MatthiasRubin/rc-truck/3d/chassis/frontSection/axleMountFrame/axleMountFrame.3mf

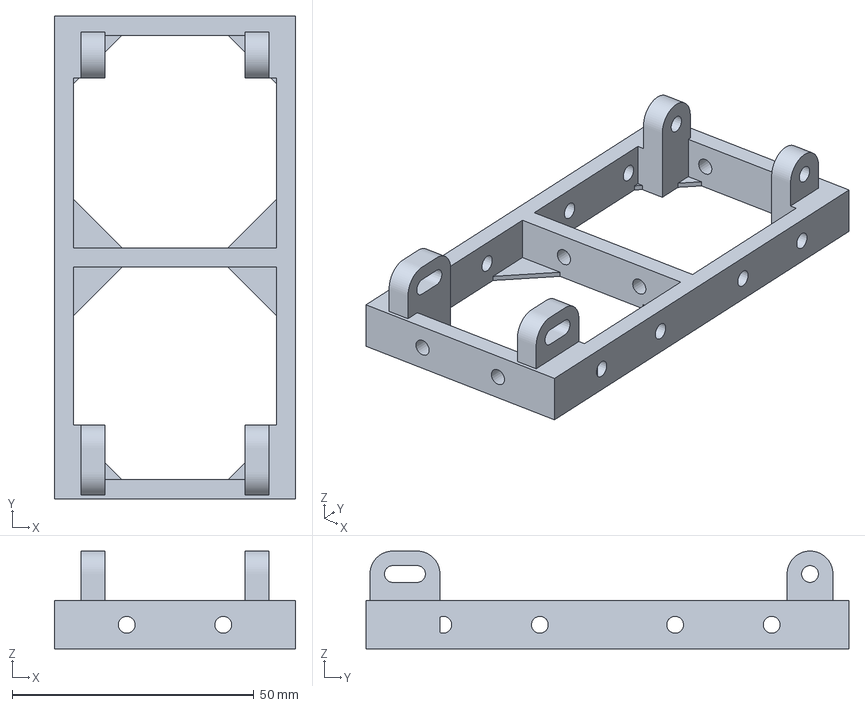
[picture p1: CAD file, 2021-02-16]
3d/chassis/frontSection/axleMountFrame/axleMountFrame.3mf
50.0 x 100.0 x 20.3 mm
