MatthiasRubin/rc-truck/3d/chassis/frontSection/frontAxle/axleBeam/axleBeamBottom.stl

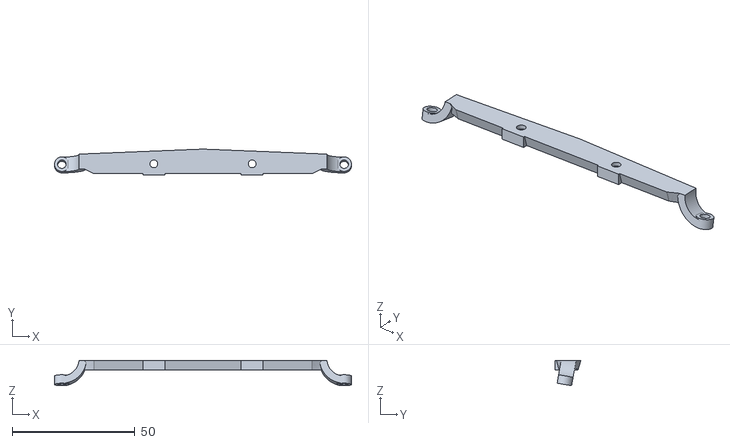
[picture p2: CAD file, 2021-02-10]
3d/chassis/frontSection/frontAxle/axleBeam/axleBeamBottom.stl
120.8 x 10.5 x 10.4
