MatthiasRubin/rc-truck/3d/chassis/frontSection/frontAxle/bearing/bearing.stl

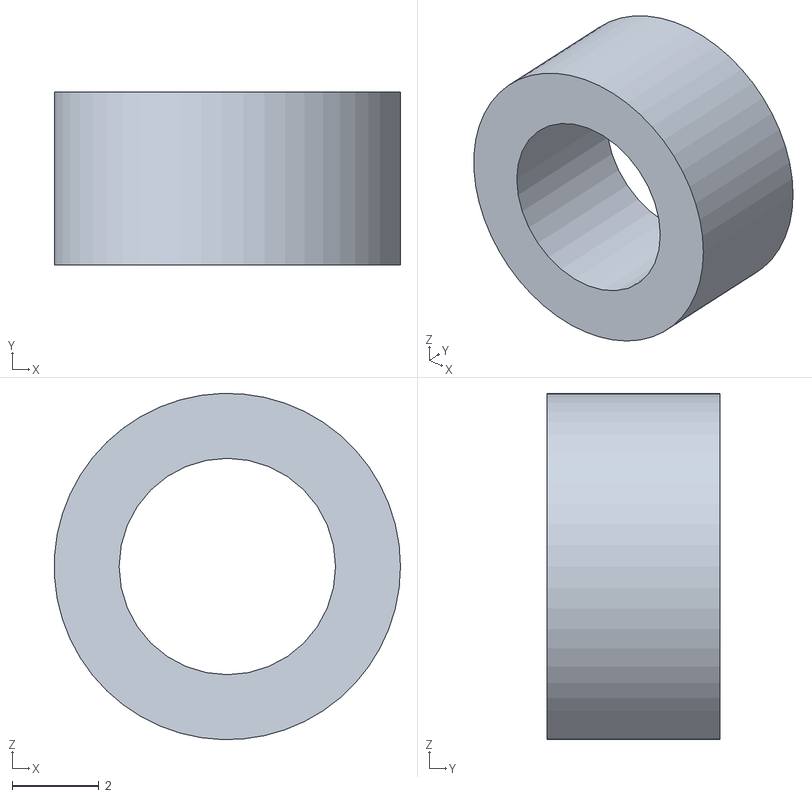
[picture p3: CAD file, 2021-02-10]
3d/chassis/frontSection/frontAxle/bearing/bearing.stl
7.99 x 4.00 x 8.00
