MatthiasRubin/rc-truck/3d/chassis/frontSection/frontAxle/shaft/shafts.3mf

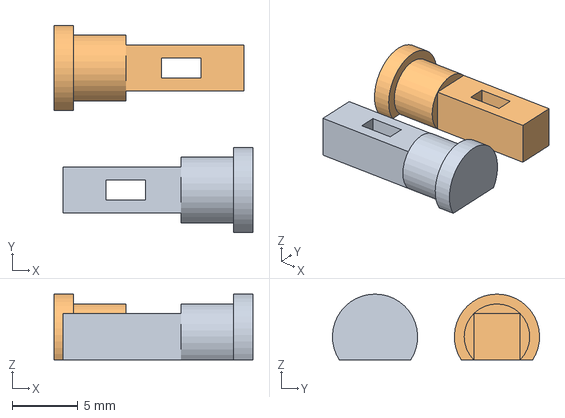
[picture p4: CAD file, 2021-02-10]
3d/chassis/frontSection/frontAxle/shaft/shafts.3mf
15.2 x 15.8 x 5.02 mm
shaft.stl
shaft.stl(1)
