MatthiasRubin/rc-truck/3d/chassis/frontSection/frontAxle/steeringKnuckles/bearingHousing.stl

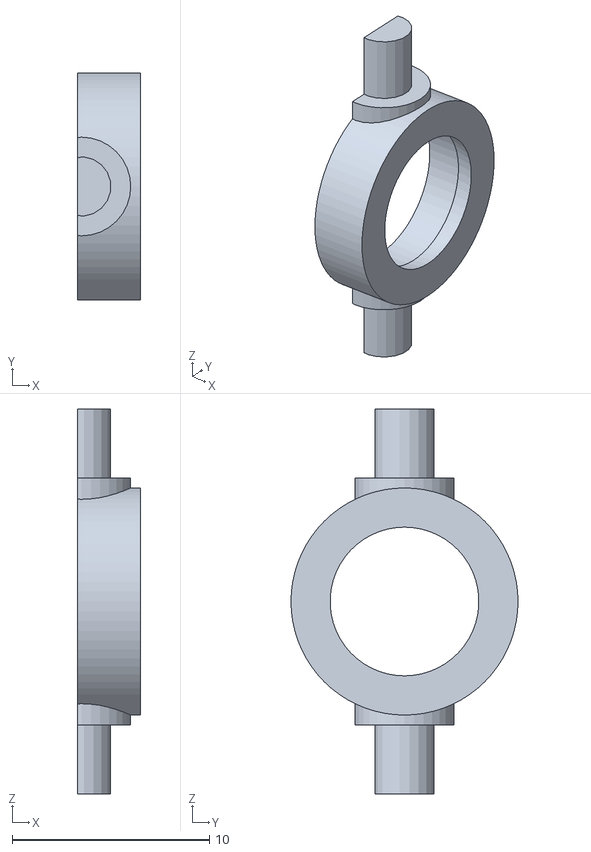
[picture p5: CAD file, 2021-02-10]
3d/chassis/frontSection/frontAxle/steeringKnuckles/bearingHousing.stl
3.20 x 11.5 x 19.5
