MatthiasRubin/rc-truck/3d/chassis/frontSection/frontAxle/steeringRod/steeringRod.3mf

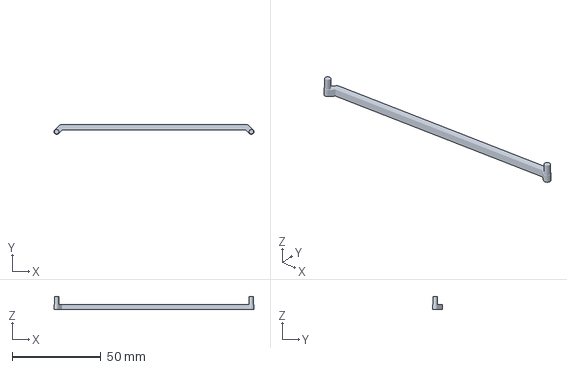
[picture p6: CAD file, 2021-02-10]
3d/chassis/frontSection/frontAxle/steeringRod/steeringRod.3mf
113.0 x 5.49 x 7.50 mm
