MatthiasRubin/rc-truck/3d/chassis/frontSection/frontAxle/wheelhub/wheelClip.stl

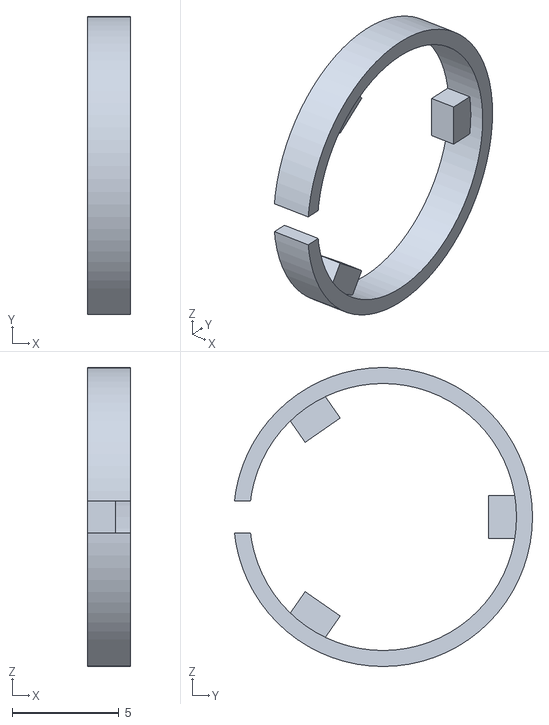
[picture p7: CAD file, 2021-02-10]
3d/chassis/frontSection/frontAxle/wheelhub/wheelClip.stl
2.00 x 14.0 x 14.0
