MatthiasRubin/rc-truck/3d/chassis/frontSection/suspension/suspension.3mf

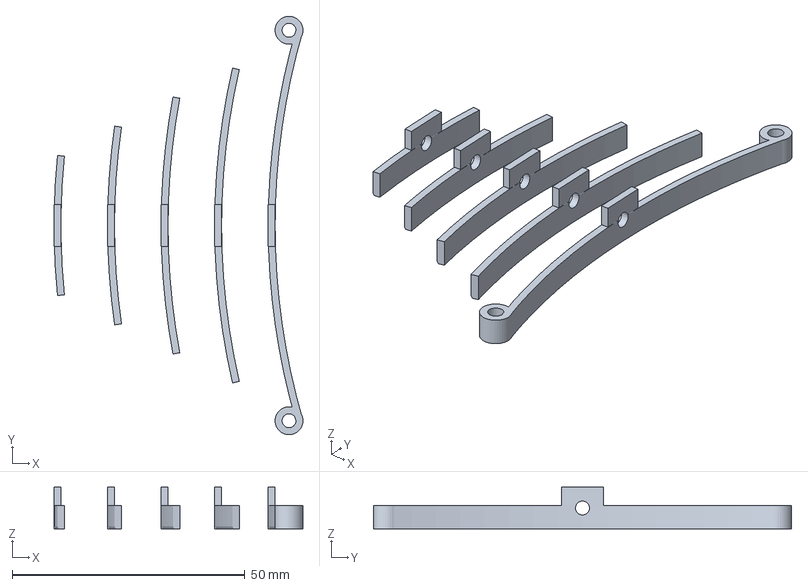
[picture p8: CAD file, 2021-02-11]
3d/chassis/frontSection/suspension/suspension.3mf
53.5 x 89.8 x 9.01 mm
