MatthiasRubin/rc-truck/3d/chassis/middleSection/middleSection.3mf

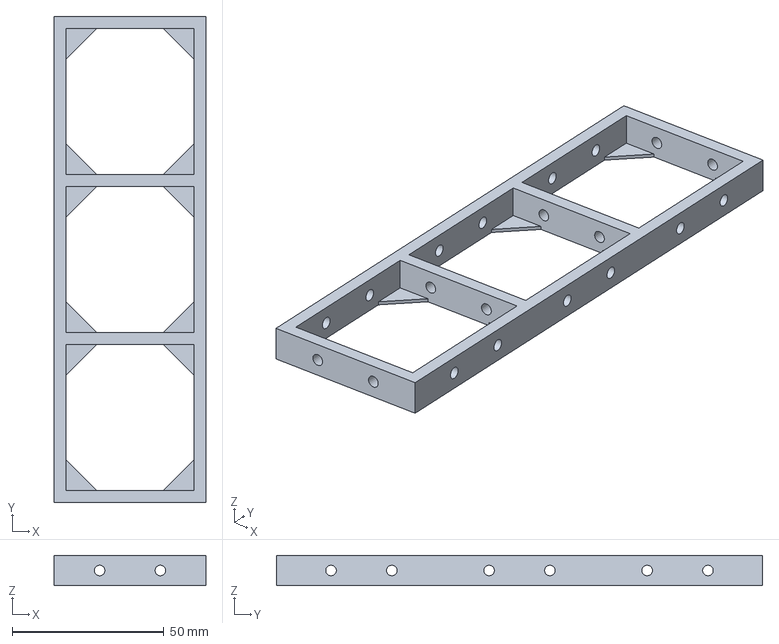
[picture p9: CAD file, 2021-02-16]
3d/chassis/middleSection/middleSection.3mf
50.0 x 160.0 x 10.0 mm
