MatthiasRubin/rc-truck/3d/chassis/rearSection/axleMountFrame/axleMountFrame.3mf

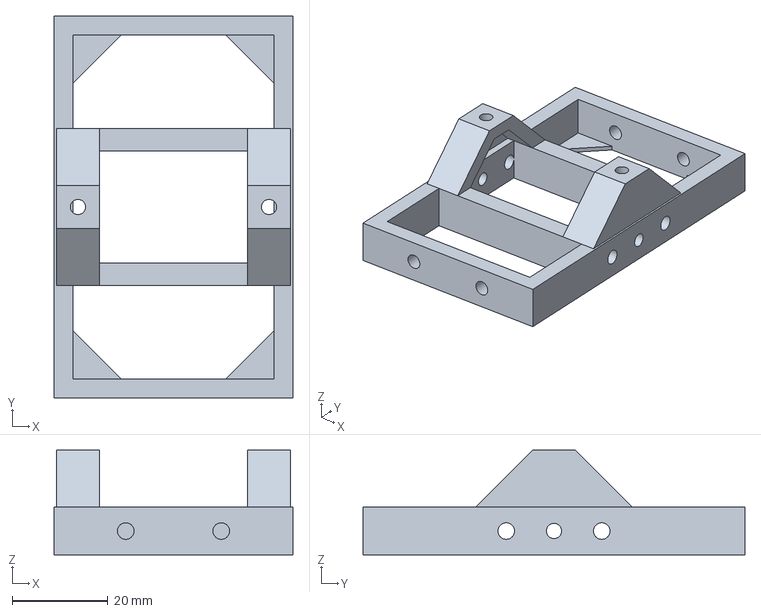
[picture p10: CAD file, 2021-02-16]
3d/chassis/rearSection/axleMountFrame/axleMountFrame.3mf
50.0 x 80.0 x 22.0 mm
