MatthiasRubin/rc-truck/3d/chassis/rearSection/rearAxle/bearings/outputBearing.stl

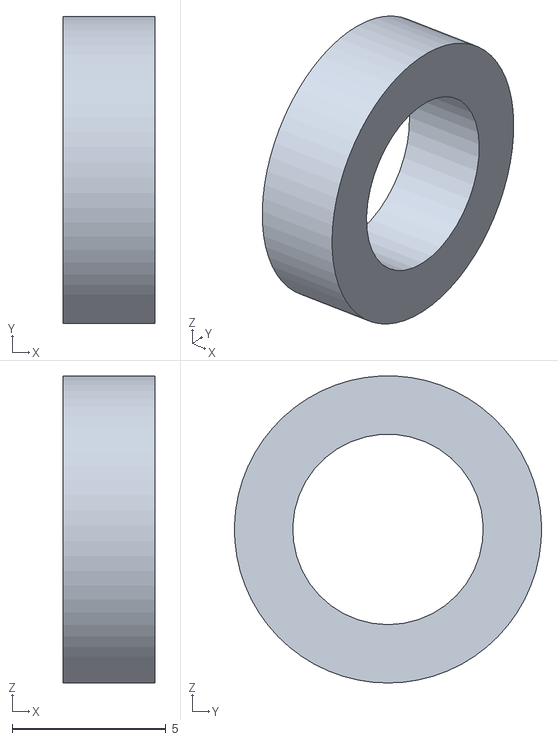
[picture p11: CAD file, 2021-02-10]
3d/chassis/rearSection/rearAxle/bearings/outputBearing.stl
3.00 x 10.00 x 9.99
