MatthiasRubin/rc-truck/3d/chassis/rearSection/rearAxle/gears/outputGear.stl

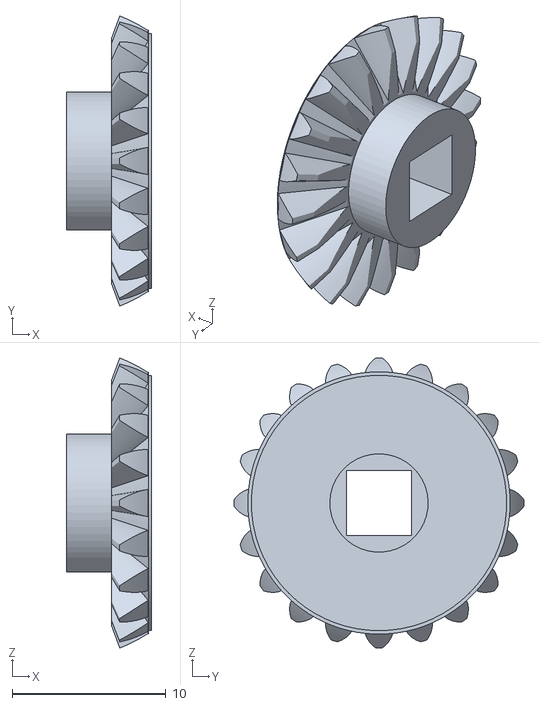
[picture p12: CAD file, 2021-02-10]
3d/chassis/rearSection/rearAxle/gears/outputGear.stl
5.51 x 18.9 x 18.9
