MatthiasRubin/rc-truck/3d/chassis/rearSection/rearAxle/housing/housingTop.3mf

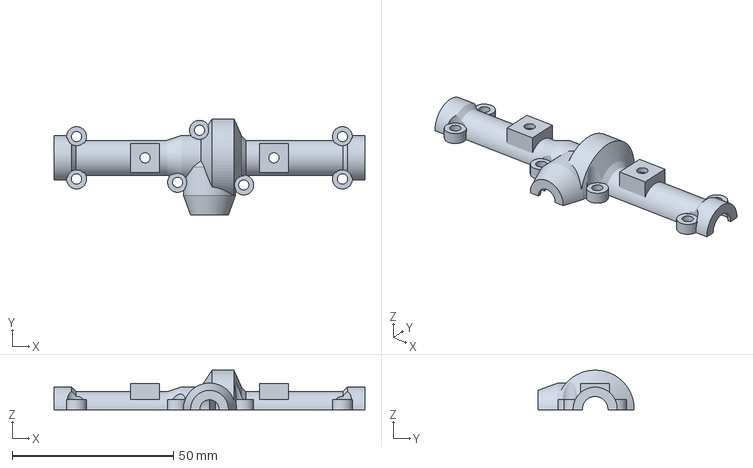
[picture p13: CAD file, 2021-02-10]
3d/chassis/rearSection/rearAxle/housing/housingTop.3mf
96.5 x 29.9 x 12.3 mm
