MatthiasRubin/rc-truck/3d/chassis/rearSection/rearAxle/shafts/inputShaft.stl

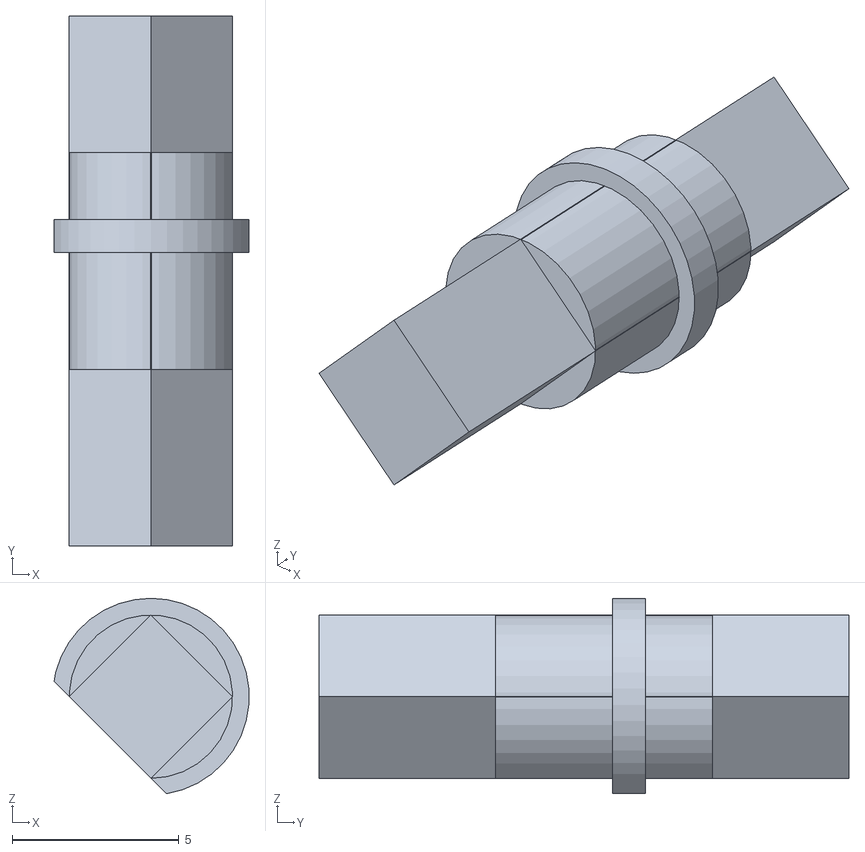
[picture p14: CAD file, 2021-02-10]
3d/chassis/rearSection/rearAxle/shafts/inputShaft.stl
5.84 x 15.9 x 5.86
