MatthiasRubin/rc-truck/3d/chassis/rearSection/rearAxle/wheelHub/wheelHub.3mf

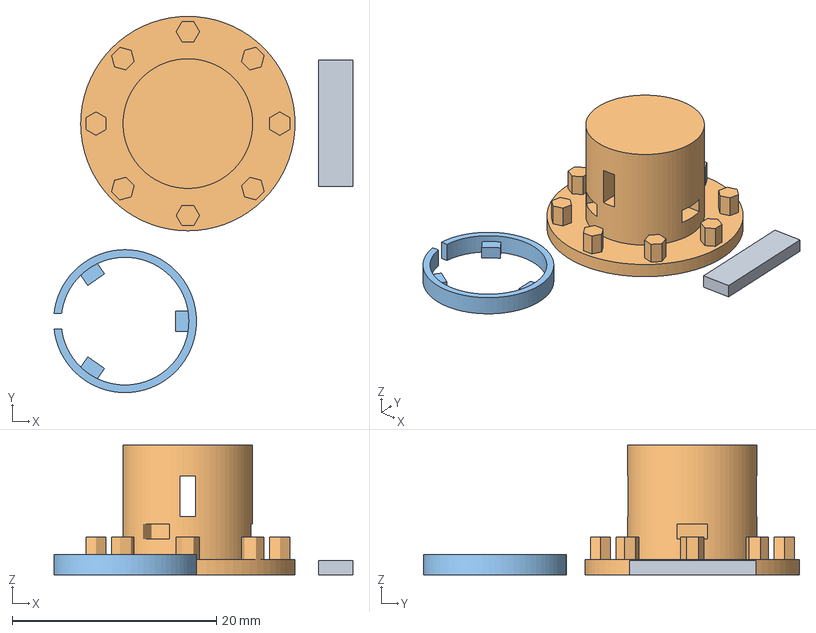
[picture p15: CAD file, 2021-02-10]
3d/chassis/rearSection/rearAxle/wheelHub/wheelHub.3mf
29.3 x 36.8 x 12.7 mm
wheelHubLatch.stl
wheelHub.stl
wheelClip.stl
