MatthiasRubin/rc-truck/3d/chassis/wheel/rim/tire.3mf

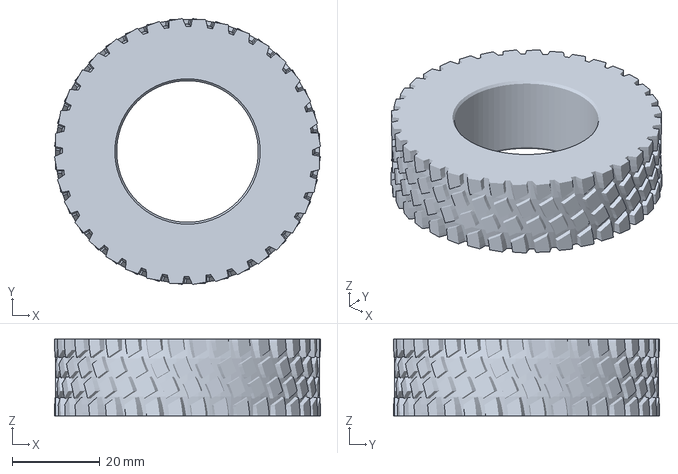
[picture p16: CAD file, 2021-02-10]
3d/chassis/wheel/rim/tire.3mf
60.5 x 60.5 x 17.5 mm
