MatthiasRubin/rc-truck/3d/chassis/wheel/tire/rim.3mf

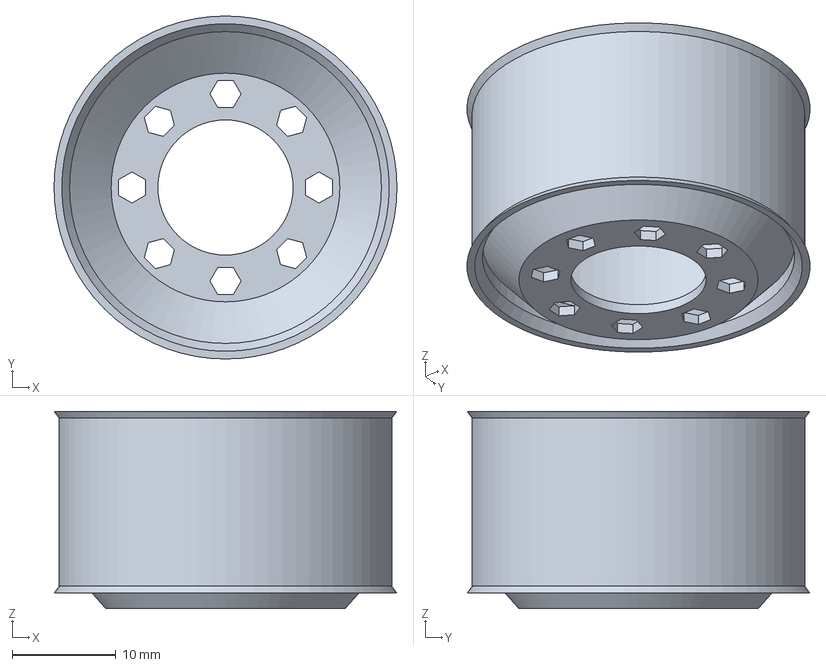
[picture p17: CAD file, 2021-02-10]
3d/chassis/wheel/tire/rim.3mf
33.0 x 33.0 x 19.0 mm
