MatthiasRubin/rc-truck/3d/chassis/frontSection/frontAxle/axleBeam/axleBeam.3mf

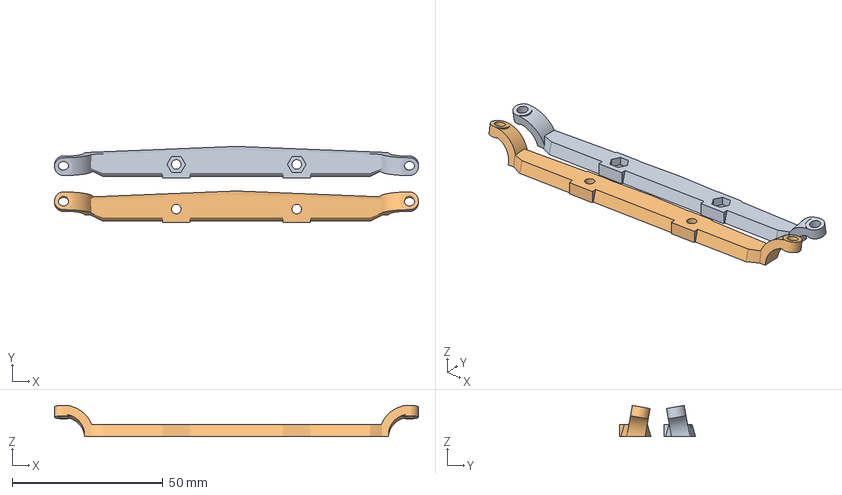
[picture p18: CAD file, 2021-02-10]
3d/chassis/frontSection/frontAxle/axleBeam/axleBeam.3mf
120.8 x 25.3 x 10.4 mm
axleBeamBottom.stl
axleBeamTop.stl
