MatthiasRubin/rc-truck/3d/chassis/frontSection/frontAxle/bearing/bearings.3mf

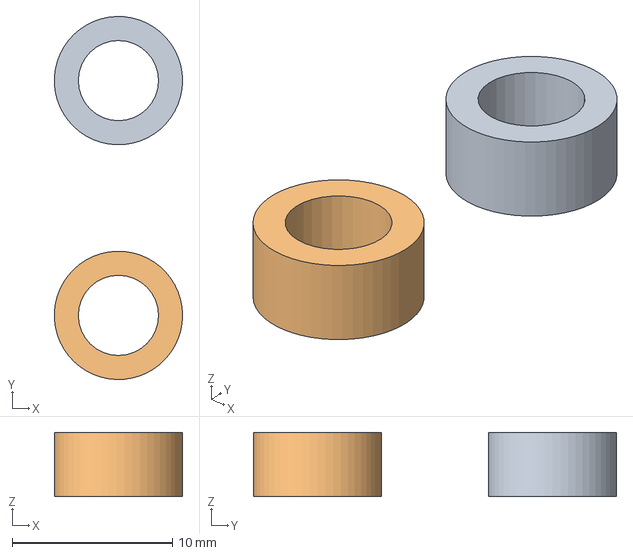
[picture p19: CAD file, 2021-02-10]
3d/chassis/frontSection/frontAxle/bearing/bearings.3mf
7.99 x 22.6 x 4.00 mm
bearing.stl
bearing.stl(1)
