MatthiasRubin/rc-truck/3d/chassis/frontSection/frontAxle/shaft/shaft.stl

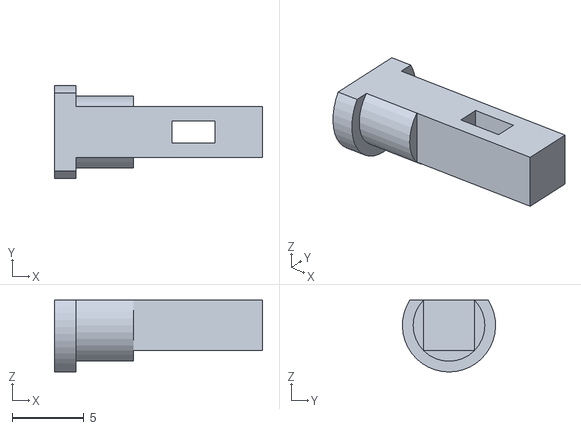
[picture p20: CAD file, 2021-02-10]
3d/chassis/frontSection/frontAxle/shaft/shaft.stl
14.5 x 6.50 x 5.02
