MatthiasRubin/rc-truck/3d/chassis/frontSection/frontAxle/steeringKnuckles/doubleSteeringKnuckle.stl

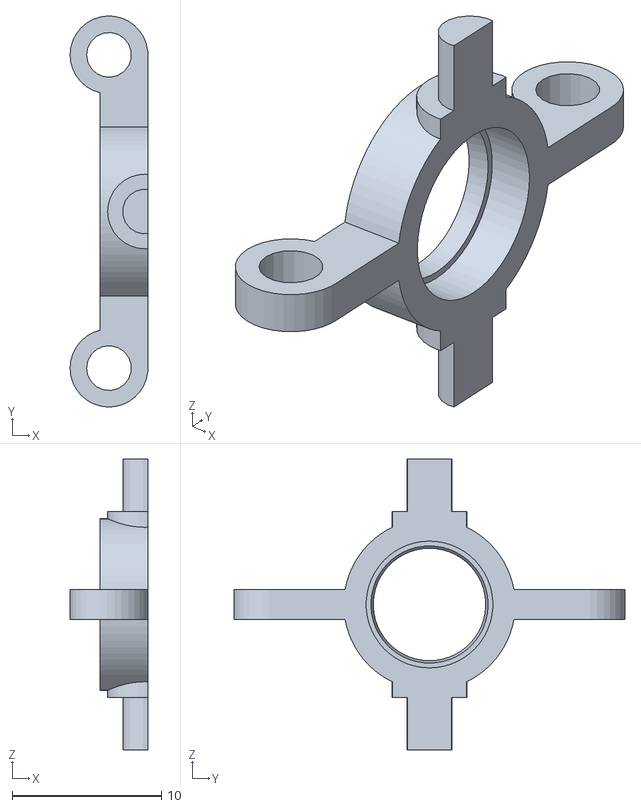
[picture p21: CAD file, 2021-02-10]
3d/chassis/frontSection/frontAxle/steeringKnuckles/doubleSteeringKnuckle.stl
5.22 x 26.2 x 19.5
