MatthiasRubin/rc-truck/3d/chassis/frontSection/frontAxle/wheelhub/wheelHubLatch.stl

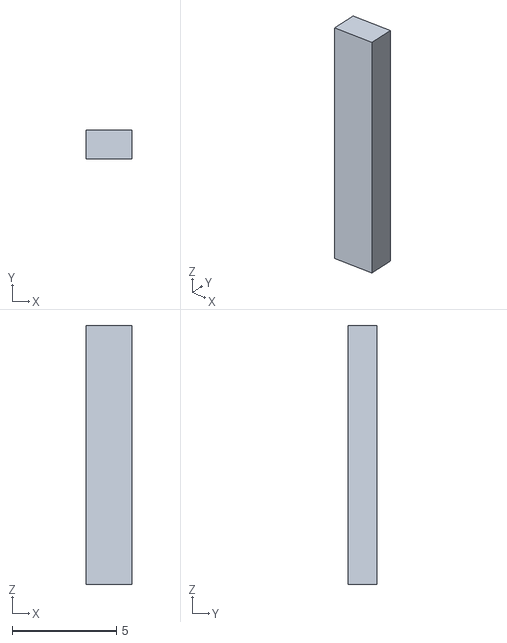
[picture p22: CAD file, 2021-02-10]
3d/chassis/frontSection/frontAxle/wheelhub/wheelHubLatch.stl
2.20 x 1.40 x 12.4
