MatthiasRubin/rc-truck/3d/chassis/rearSection/rearAxle/bearings/inputBearing.stl

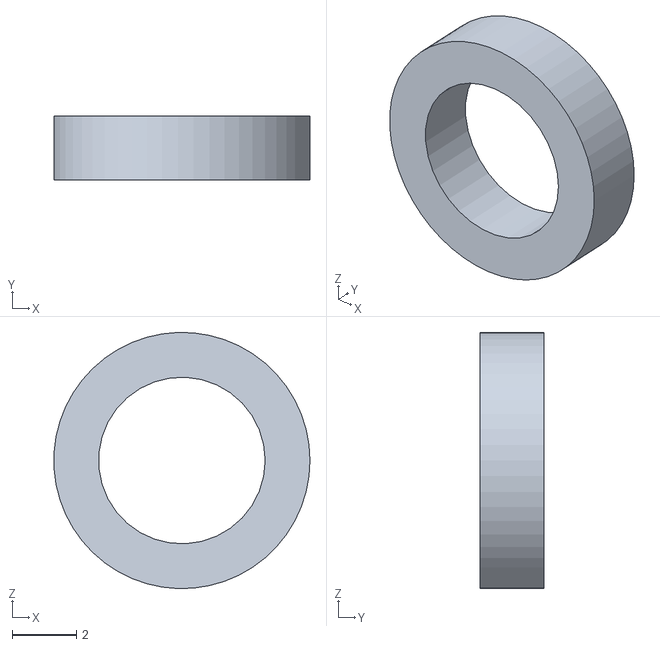
[picture p23: CAD file, 2021-02-10]
3d/chassis/rearSection/rearAxle/bearings/inputBearing.stl
7.99 x 2.00 x 8.00
