MatthiasRubin/rc-truck/3d/chassis/rearSection/rearAxle/gears/gears.3mf

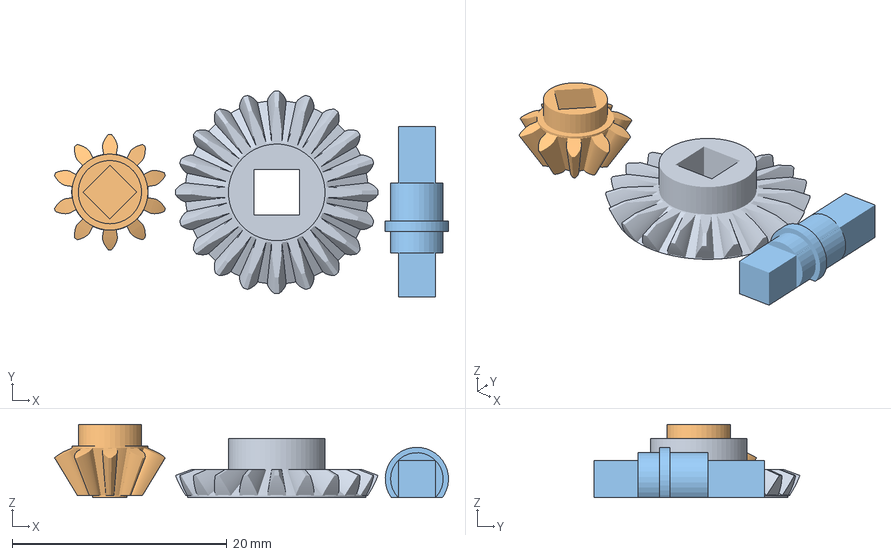
[picture p24: CAD file, 2021-02-10]
3d/chassis/rearSection/rearAxle/gears/gears.3mf
36.7 x 19.2 x 6.81 mm
outputGear.stl
inputGear.stl
inputShaft.stl
