MatthiasRubin/rc-truck/3d/chassis/rearSection/rearAxle/housing/housingBottom.3mf

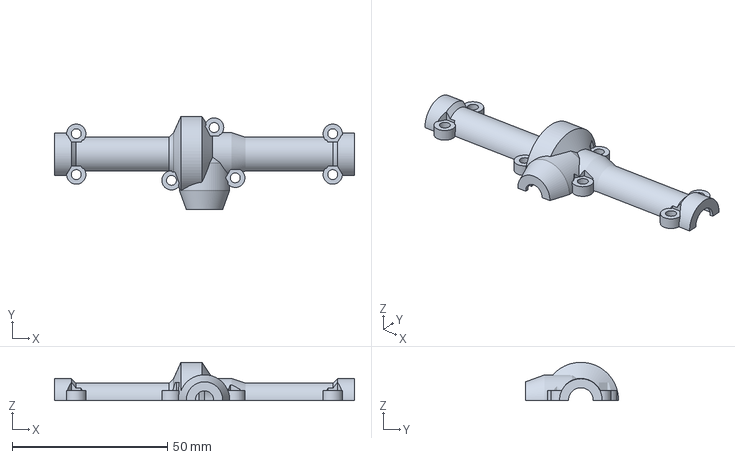
[picture p25: CAD file, 2021-02-10]
3d/chassis/rearSection/rearAxle/housing/housingBottom.3mf
96.5 x 29.9 x 12.3 mm
