MatthiasRubin/rc-truck/3d/chassis/rearSection/rearAxle/shafts/shafts.3mf

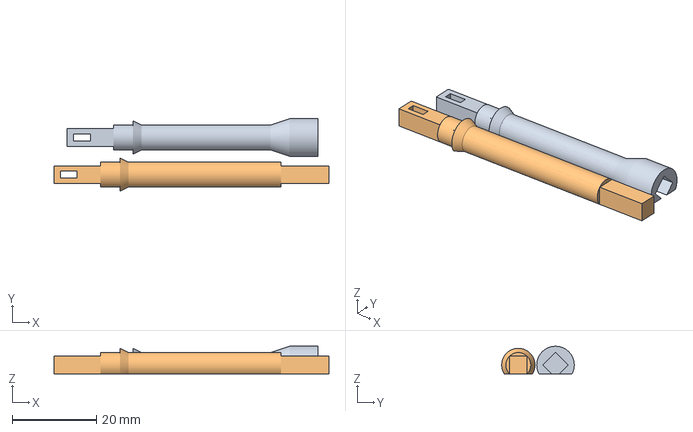
[picture p26: CAD file, 2021-02-10]
3d/chassis/rearSection/rearAxle/shafts/shafts.3mf
65.1 x 17.2 x 6.54 mm
rightShaft.stl
leftShaft.stl
