MatthiasRubin/rc-truck/3d/chassis/rearSection/rearAxle/wheelHub/wheelHubLatch.stl

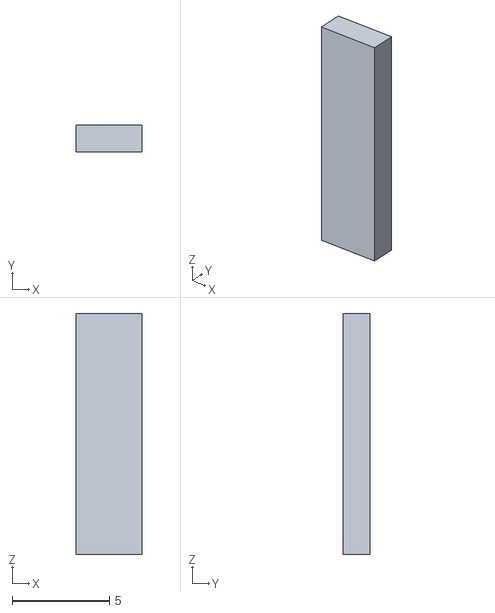
[picture p27: CAD file, 2021-02-10]
3d/chassis/rearSection/rearAxle/wheelHub/wheelHubLatch.stl
3.40 x 1.40 x 12.4
