MatthiasRubin/rc-truck/3d/chassis/frontSection/frontAxle/steeringKnuckles/steeringKnuckle.stl

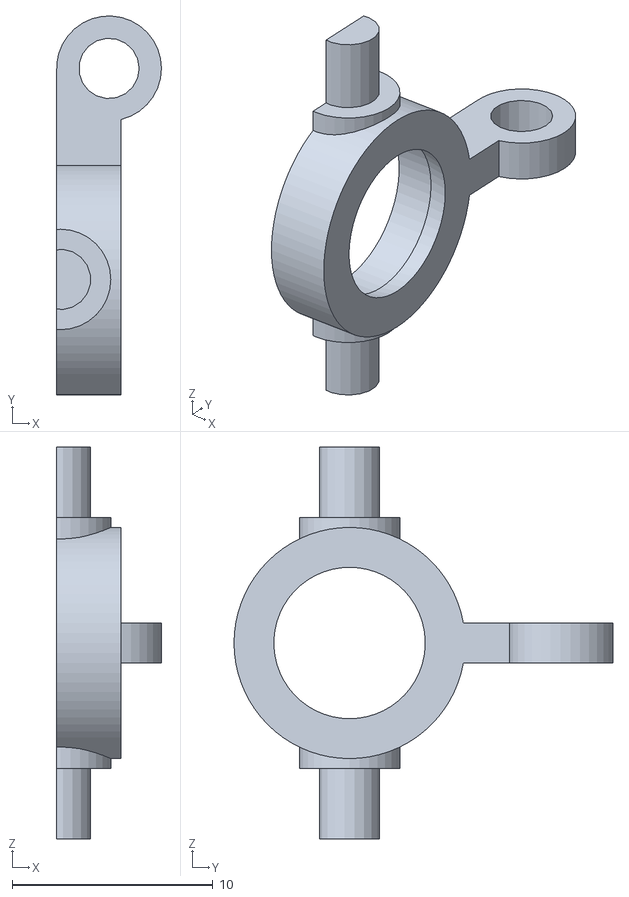
[picture p28: CAD file, 2021-02-10]
3d/chassis/frontSection/frontAxle/steeringKnuckles/steeringKnuckle.stl
5.22 x 18.9 x 19.5
