MatthiasRubin/rc-truck/3d/chassis/frontSection/frontAxle/wheelhub/wheelHub.3mf

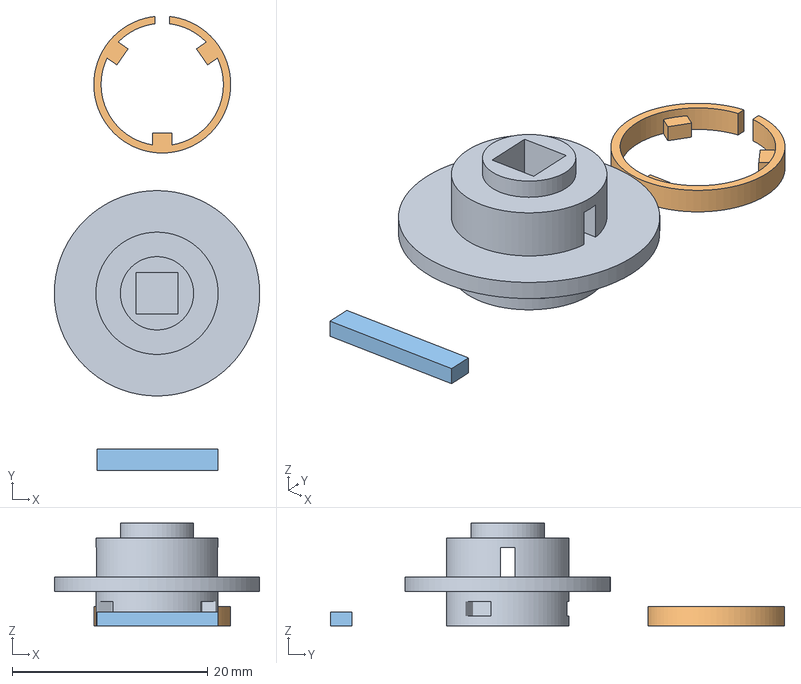
[picture p29: CAD file, 2021-02-10]
3d/chassis/frontSection/frontAxle/wheelhub/wheelHub.3mf
21.0 x 46.4 x 10.5 mm
wheelHub.stl
wheelClip.stl
wheelHubLatch.stl
