MatthiasRubin/rc-truck/3d/chassis/rearSection/rearAxle/bearings/bearings.3mf

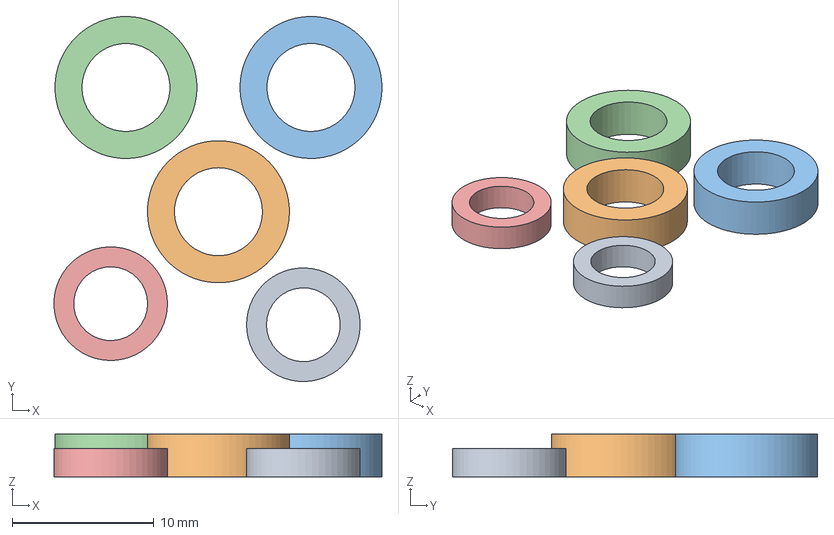
[picture p30: CAD file, 2021-02-10]
3d/chassis/rearSection/rearAxle/bearings/bearings.3mf
23.1 x 25.7 x 3.00 mm
inputBearing.stl
outputBearing.stl
outputBearing.stl(1)
outputBearing.stl(2)
inputBearing.stl(1)
