MatthiasRubin/rc-truck/3d/chassis/rearSection/rearAxle/gears/inputGear.stl

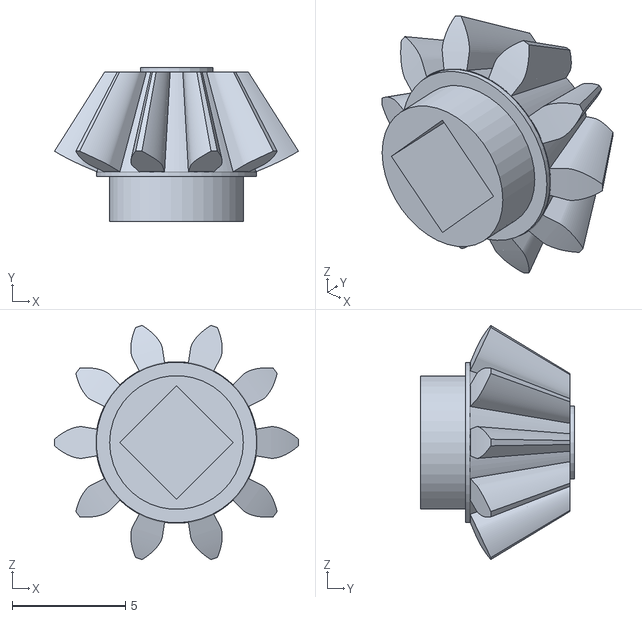
[picture p31: CAD file, 2021-02-10]
3d/chassis/rearSection/rearAxle/gears/inputGear.stl
10.8 x 6.81 x 10.3
