MatthiasRubin/rc-truck/3d/chassis/rearSection/rearAxle/shafts/leftShaft.stl

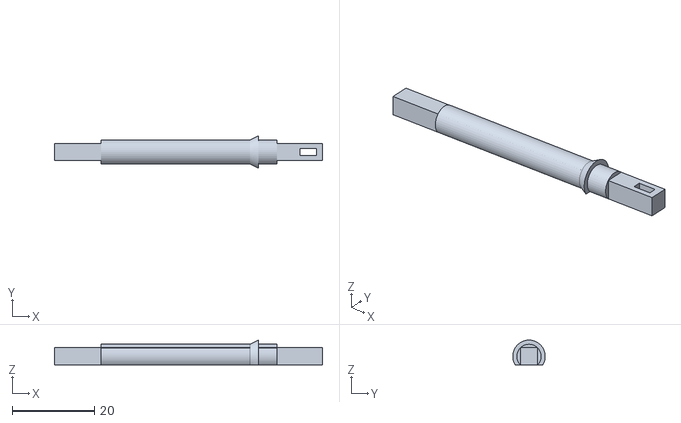
[picture p32: CAD file, 2021-02-10]
3d/chassis/rearSection/rearAxle/shafts/leftShaft.stl
65.1 x 7.88 x 6.04
