MatthiasRubin/rc-truck/3d/chassis/frontSection/frontAxle/steeringKnuckles/steeringKnuckles.3mf

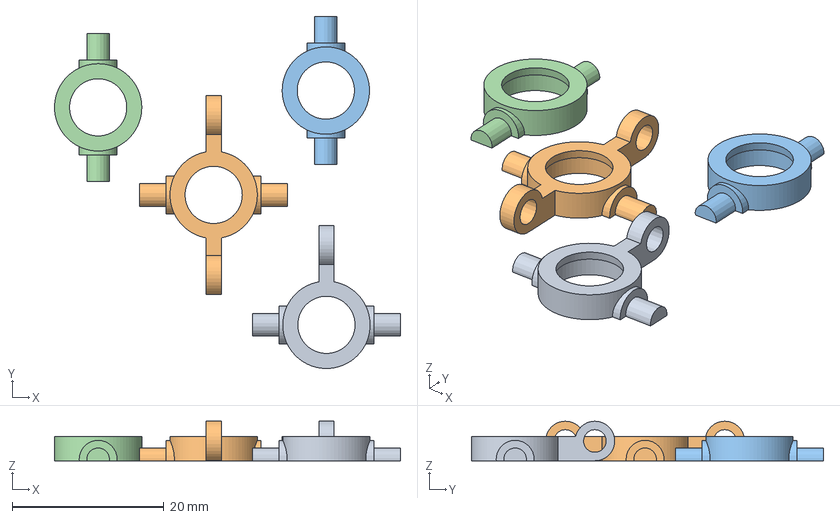
[picture p33: CAD file, 2021-02-10]
3d/chassis/frontSection/frontAxle/steeringKnuckles/steeringKnuckles.3mf
45.6 x 46.4 x 5.22 mm
steeringKnuckle.stl
doubleSteeringKnuckle.stl
bearingHousing.stl
bearingHousing.stl(1)
