MatthiasRubin/rc-truck/3d/chassis/rearSection/rearAxle/shafts/rightShaft.stl

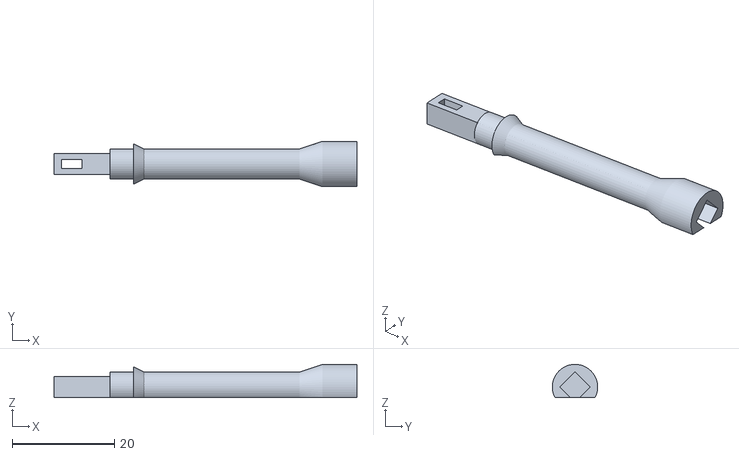
[picture p34: CAD file, 2021-02-10]
3d/chassis/rearSection/rearAxle/shafts/rightShaft.stl
59.4 x 8.90 x 6.54
