MatthiasRubin/rc-truck/frontAxle.scad

// this file defines the front axle


// used modules
use <copy.scad>
use <transform.scad>


// used parts
use <wheel.scad>


// global definitions
$fa = 5;
$fs = 0.5;
$vpd = 280;


// local definitions

// wall thickness
thinWall = 1;
strongWall = 1.5;

// steering geometry
wheelbase = 250;
caster = 10;

// wheel hub latch
wheelHubLatchSize = 3;

// wheel hub
wheelHubEndStopLength = thinWall + 0.5;
wheelHubLatchOffset = wheelHubLatchSize/2 + thinWall + wheelHubEndStopLength;
wheelOffset = wheelHubEndStopLength + thinWall + wheelHubLatchSize + strongWall + getRimThickness();
shaftConnectionLenght = wheelOffset + thinWall;
wheelHubDepth = shaftConnectionLenght + strongWall;

// shaft
shaftDiameter = 5;

// bearing
bearingOuterDiameter = 8.5;
bearingInnerDiameter = 5;
bearingWidth = 4;

// steering knuckle
steeringPinDiameter = 3;
steeringKnuckleSize = getPitchCircleDiameter()/2 + getWheelScrewDiameter()/2;
bearingHousingDiameter = bearingOuterDiameter + 2*strongWall;

// axle beam
axleBeamThickness = 4;
axleBeamWidth = 5;

// screws
screwDiameter = 3;
screwHeadDiameter = 5.5;
nutDiameter = 6.01;
nutWidth = 2.4;

// axle mount
axleMountDistance = 40;


// shows front axle
frontAxle();


// assembled front axle
module frontAxle(width = 140)
{
  translateZ(-axleBeamThickness)
  {
    // local definitions
    wheelHubOffset = width/2 - wheelHubDepth;
    bearingOffset = wheelHubOffset - bearingWidth/2 - 0.1;
    
    // axle beam
    axleBeamLength = 2*bearingOffset;
    axleBeamTop(axleBeamLength);
    axleBeamBottom(axleBeamLength);
    
    rotateX(-caster)
    {
      // steering knuckles
      steeringOffset = steeringKnuckleSize * bearingOffset / wheelbase;
      translateX(-bearingOffset) steeringKnuckle(steeringOffset);
      translateX(bearingOffset) doubleSteeringKnuckle(steeringOffset);
      
      // bearings
      rotateCopyZ(180)
      {
        translateX(bearingOffset)
        {
          rotateZ(90) bearing();
          bearingHousing();
        }
      }
      
      // steering rod
      steeringRodLength = 2*(bearingOffset - steeringOffset);
      translateY(steeringKnuckleSize) steeringRod(steeringRodLength);
    }
    
    rotateCopyZ(180)
    {
      // shafts
      shaftOffset = wheelHubOffset - bearingWidth - 0.2;
      translateX(shaftOffset) shaft();
      
      // wheel hubs
      translateX(wheelHubOffset) 
      {
        wheelHub();
        wheelHubLatch();
      }
      
      // wheels
      wheelOffset = wheelHubOffset + wheelOffset;
      translateX(-wheelOffset) wheel();
      
      // wheel clips
      wheelClipOffset = wheelOffset - getRimThickness();
      translateX(wheelClipOffset) wheelClip();
    }
  }
}


// axle beam: top half
module axleBeamTop(length)
{
  difference()
  {
    // basic axle beam
    basicAxleBeam(length);
    
    // remove bottom
    translateZ(-length) cube(2*length, center = true);
  }
}


// axle beam: bottom half
module axleBeamBottom(length)
{
  difference()
  {
    // basic axle beam
    basicAxleBeam(length);
    
    // remove top
    translateZ(length) cube(2*length, center = true);
  }
}


// basic axle beam
module basicAxleBeam(length)
{
  translateY(thinWall)
  {
    // steering knuckle joints
    steeringJointOffset = length/2;
    steeringJointWidth = steeringPinDiameter + 2*strongWall;
    steeringKnuckleSize = bearingHousingDiameter + thinWall + 0.5;
    steeringJointInnerDiameter = steeringKnuckleSize + 1;
    steeringJointOuterDiameter = steeringJointInnerDiameter + steeringJointWidth;
    mirrorCopyX() translateX(steeringJointOffset) rotateX(-caster)
    {
      rotateX(90) difference()
      {
        // basic joint
        cylinder(d = steeringJointOuterDiameter, h = steeringJointWidth, center = true);
        
        // shape basic joint
        cylinder(d = steeringJointInnerDiameter, h = steeringJointWidth+1, center = true);
        
        // hole steering knuckle pins
        holeDiameter = steeringJointWidth-1;
        holeDepth = steeringJointOuterDiameter+1;
        rotateX(90) cylinder(d = holeDiameter, h = holeDepth, center = true);
        
        // remove unused material
        translateX(holeDepth/2) cube(holeDepth, center = true);
      }
      
      difference()
      {
        // rounding
        cylinder(d = steeringJointWidth, h = steeringJointOuterDiameter, center = true);
        
        // remove unuse material
        cylinder(d = steeringJointWidth+1, h = steeringKnuckleSize, center = true);
        
        // hole steering knuckle pins
        holeDiameter = steeringPinDiameter + 0.5;
        holeDepth = steeringJointOuterDiameter+1;
        cylinder(d = holeDiameter, h = holeDepth, center = true);
      }
    }
    
    difference()
    {
      axleMountOffset = axleMountDistance/2;
      axleMountHeight = 2*axleBeamThickness;
      
      union()
      {
        // front axle beam
        minimalWidth = steeringJointWidth / (2*cos(caster));
        scaleFactor = 1 - axleBeamThickness * tan(caster) / minimalWidth;
        length = length/2
          - sqrt((steeringJointOuterDiameter/2)^2 - (axleBeamThickness/cos(caster))^2);
        reductionOffset = length - 2*(axleBeamWidth-minimalWidth);
        mirrorCopyZ() linear_extrude(axleBeamThickness, scale = [1,scaleFactor]) mirrorCopyX()
          polygon([
            [length,minimalWidth],
            [0,axleBeamWidth],
            [0,-axleBeamWidth],
            [reductionOffset,-axleBeamWidth],
            [length,-minimalWidth]
          ]);
        
        // support to mount axle
        axleMountSize = nutDiameter + 2*strongWall;
        mirrorCopyX() translate([axleMountOffset,-thinWall,0])
          cube([axleMountSize,axleMountSize,axleMountHeight], center = true);
      }
      
      // holes to mount axle
      mirrorCopyX() translate([axleMountOffset,-thinWall,0])
      {
        // hole for screws
        screwHole = screwDiameter + 0.2;
        cylinder(d = screwHole, h = axleMountHeight+1, center = true);
      
        // hole for nuts
        nutHole = nutDiameter + 0.2;
        nutHoleDepth = nutWidth + 0.2;
        axleMountNutHoleDepth = nutHoleDepth + 1;
        translateZ(-axleBeamThickness-1) cylinder(d = nutHole, h = axleMountNutHoleDepth, $fn = 6);
      }
    }
  }
}

// doubled steering knuckle
module doubleSteeringKnuckle(steeringOffset)
{
  // combine two steering knuckles
  mirrorX() mirrorCopyY() steeringKnuckle(steeringOffset);
}


// steering knuckle
module steeringKnuckle(steeringOffset)
{
  // basic bearing housing
  bearingHousing();
 
  difference()
  {
    steeringArmThickness = 2*thinWall;
    
    translateX(-0.2) union()
    {
      // steering arm
      steeringArmLength = steeringKnuckleSize - bearingOuterDiameter/2;
      steeringArmWidth = bearingWidth/2 + thinWall + 0.2;
      translate([0,bearingOuterDiameter/2,-steeringArmThickness/2]) 
        cube([steeringArmWidth,steeringArmLength,steeringArmThickness]);
      
      // steering rod joint
      steeringOffset = steeringOffset+0.2;
      translate([steeringOffset,steeringKnuckleSize,0]) 
        cylinder(r = steeringOffset, h = steeringArmThickness, center = true);
    }
     
    // hole for steering rod
    translate([steeringOffset,steeringKnuckleSize,0]) 
      cylinder(d = steeringPinDiameter, h = steeringArmThickness+1, center = true);
  }
}


// bearing housing
module bearingHousing()
{
  rotateY(90) difference()
  {
    union()
    {
      // basic housing
      housingWidth = bearingWidth + 2*thinWall;
      cylinder(d = bearingHousingDiameter, h = housingWidth, center = true);
      
      // steering pin support
      pinSupportDiameter = steeringPinDiameter + 2*thinWall;
      pinSupportLength = bearingHousingDiameter + thinWall;
      rotateY(90) cylinder(d = pinSupportDiameter, h = pinSupportLength, center = true);
      
      // steering pins
      pinHeight = pinSupportLength + 2*steeringPinDiameter + thinWall;
      rotateY(90) cylinder(d = steeringPinDiameter, h = pinHeight, center = true);
    }
    
    // hole for bearing
    cylinder(d = bearingOuterDiameter, h = bearingWidth, center = true);
    
    // hole for shaft
    shaftHoleDiameter = bearingOuterDiameter - thinWall;
    shaftHoleDepth = bearingWidth/2 + thinWall + 0.1;
    cylinder(d1 = bearingOuterDiameter, d2 = shaftHoleDiameter, h = shaftHoleDepth);
    
    // flat bottom
    boxSize = 2*shaftHoleDiameter + 4*strongWall;
    boxOffset = boxSize/2 + 0.2;
    translateZ(-boxOffset) cube(boxSize, center = true);
  }
}


// steering track rod
module steeringRod(length)
{
  steeringRodThickness = 2*thinWall;
  
  translateZ(steeringRodThickness)
  {
    steeringRodWidth = 2*strongWall;
    steeringRodOffset = strongWall + thinWall;
    translateY(-steeringRodOffset)
    {
      // basic steering rod
      steeringRodLength = length - 2*steeringRodOffset;
      cube([steeringRodLength,steeringRodWidth,steeringRodThickness], center = true);
    
      mirrorCopyX() translateX(steeringRodLength/2)
      {
        // brackets
        bracketLength = sqrt(2) * steeringRodOffset;
        bracketOffset = [steeringRodOffset/2,steeringRodOffset/2,0];
        translate(bracketOffset) rotateZ(45)
          cube([bracketLength,steeringRodWidth,steeringRodThickness], center = true);
        
        // bracket roundings
        cylinder(d = steeringRodWidth, h = steeringRodThickness, center = true);
      }
    }
        
    mirrorCopyX() translateX(length/2)
    {
      
      // roundings
      cylinder(d = steeringRodWidth, h = steeringRodThickness, center = true);
      
      // steering knuckle joint pins
      pinDiameter = steeringPinDiameter - 0.5;
      pinLength = 2*steeringRodThickness;
      mirrorZ() cylinder(d = pinDiameter, h = pinLength);
    }
  }
}


// shaft
module shaft()
{
  rotateY(90) translateZ(-strongWall) difference()
  {
    union()
    {
      // basic shaft
      basicShaftLength = strongWall + bearingWidth;
      cylinder(d = shaftDiameter, h = basicShaftLength);
    
      // end stop
      endStopDimeter = shaftDiameter + strongWall;
      cylinder(d = endStopDimeter, h = strongWall);
      
      // shaft connection
      shaftConnectionLenght = shaftConnectionLenght + basicShaftLength;
      rotateZ(45) cylinder(d = shaftDiameter, h = shaftConnectionLenght, $fn = 4);
    }
    
    // hole for wheel hub latch
    wheelHubLatchOffset = wheelHubLatchOffset + bearingWidth + strongWall + 0.2;
    translateZ(wheelHubLatchOffset)
      cube([getRimHoleDiameter(),strongWall,wheelHubLatchSize], center = true);
    
    // flat bottom
    boxLength = 3*(shaftConnectionLenght + bearingWidth);
    boxSize = 2*shaftDiameter;
    bottomOffset = boxSize/2 + sqrt(shaftDiameter^2 / 2)/2;
    translateX(-bottomOffset) cube([boxSize,boxSize,boxLength], center = true);
  }
}


// wheel hub
module wheelHub()
{
  rotateY(90) difference()
  {
    translateZ(wheelHubEndStopLength)
    {
      // basic wheel hub
      wheelHubDiameter = getPitchCircleDiameter() + getWheelScrewDiameter();
      wheelHubOffset = wheelHubLatchSize + thinWall;
      translateZ(wheelHubOffset) cylinder(d = wheelHubDiameter, h = strongWall);
      
      // shaft mount
      shaftMountDiameter = getRimHoleDiameter() - 0.5;
      shaftMountLength = wheelHubDepth - wheelHubEndStopLength;
      cylinder(d = shaftMountDiameter, h = shaftMountLength);
    
      // end stop
      endStopDiameter = shaftDiameter + 2*thinWall + 0.5;
      translateZ(-wheelHubEndStopLength) cylinder(d = endStopDiameter, h = wheelHubEndStopLength);
    }
    
    // hole for shaft
    shaftHoleDiameter = shaftDiameter + 1;
    translateZ(-1) rotateZ(45)
      cylinder(d = shaftHoleDiameter, h = shaftConnectionLenght + 1.5, $fn = 4);
    
    // hole for wheel hub latch
    translateZ(wheelHubLatchOffset)
      cube([getRimHoleDiameter(),strongWall,wheelHubLatchSize], center = true);
    
    // holes for wheel clip
    clipHoleHeight = strongWall;
    clipHoleWidth = 2*strongWall;
    clipHoleDepth = 2*thinWall + 0.5;
    clipHoleOffsetY = getRimHoleDiameter()/2 - clipHoleDepth/2 + 0.5;
    clipHoleOffsetZ = wheelOffset + clipHoleHeight/2;
    rotateCopyZ(120,2, center = true) translate([0,clipHoleOffsetY,clipHoleOffsetZ])
      cube([clipHoleWidth,clipHoleDepth,clipHoleHeight], center = true);
  }
}


// wheel hub latch
module wheelHubLatch()
{
  latchLength = getRimHoleDiameter() - 0.6;
  latchSize = wheelHubLatchSize - 0.8;
  latchThickness = strongWall - 0.1;
  translateX(wheelHubLatchOffset)
    cube([latchSize,latchThickness,latchLength], center = true);
}


// wheel bearing
module bearing()
{
  rotateX(90) difference()
  {
    // basic shape
    cylinder(d = bearingOuterDiameter, h = bearingWidth, center = true);
    
    // hole
    cylinder(d = bearingInnerDiameter, h = bearingWidth+1, center = true);
  }
}
