MatthiasRubin/rc-truck/rc-truck.scad

// this file defines the fully assembled truck


// used parts
use <chassis.scad>


// shows truck
truck();


// fully assembled truck
module truck()
{
  // chassis
  chassis();
  
  // cabin in front
  translate([0,-200,25]) cabin();
  
  // cargo box in the back
  translate([0,80,100]) cargoBox();
}


// cargo box
module cargoBox()
{
  cube([140,340,150], center = true);
}


// driver cabin
module cabin()
{
  translate([0,50,50]) cube([140,100,100], center = true);
  translate([0,15,-15]) cube([140,30,30], center = true);
}
