MatthiasRubin/rc-truck/(list of files, cad)

Other CAD files:
3d/chassis/frontSection/frontAxle/axleBeam/axleBeamTop.stl
3d/chassis/rearSection/rearAxle/wheelHub/wheelClip.stl
3d/chassis/driveShaft.scad
3d/chassis/frontSection/motor.scad
3d/chassis/frontSection/servo.scad
3d/chassis/frontSection/steering.scad
3d/chassis/wheel/wheel.scad
3d/chassis/frontSection/frontAxle/frontAxle.scad
3d/chassis/rearSection/rearAxle/rearAxle.scad
3d/chassis/frontSection/axleMountFrame/axleMountFrame.stl
3d/chassis/frontSection/frontAxle/steeringRod/steeringRod.stl
3d/chassis/frontSection/frontAxle/wheelhub/wheelHub.stl
3d/chassis/frontSection/suspension/suspension.stl
3d/chassis/middleSection/middleSection.stl
3d/chassis/rearSection/axleMountFrame/axleMountFrame.stl
3d/chassis/rearSection/rearAxle/housing/housingBottom.stl
3d/chassis/rearSection/rearAxle/housing/housingTop.stl
3d/chassis/rearSection/rearAxle/wheelHub/wheelHub.stl
3d/chassis/wheel/rim/tire.stl
3d/chassis/wheel/tire/rim.stl
3d/modules/Getriebe.scad
