MatthiasRubin/rc-truck/(threads)

Thread 4 (2021-01-03):

Printed rear axle

MatthiasRubin, 2021-01-03:

MatthiasRubin, 2021-01-04:
![Uploading 103570032...]

MatthiasRubin, 2021-01-04:
![Uploading 6170E5C1-9B50-48C0-87E2-F27DC4123564.jpeg…]()

MatthiasRubin, 2021-01-04:
Rear axle successfully printed. Bearings needed for functional version (#9).

Closed 2021-01-04.

Thread 5 (2021-01-03):

Printed frame

MatthiasRubin, 2021-01-03:
Print frame and assemble it.

MatthiasRubin, 2021-01-04:
![Uploading 103569963...]

MatthiasRubin, 2021-01-04:
![Uploading 9FDEAC3A-2049-4E15-9590-588C94313C6F.jpeg…]()

MatthiasRubin, 2021-01-04:
Frame printed.

MatthiasRubin, 2021-01-04:
Frame printed successfully

Closed 2021-01-04.

Thread 10 (2021-01-04):

Enhanced front axle

MatthiasRubin, 2021-01-04:
- Thinner and smoother design
- Enhance Ackermann steering
- Add new front wheel
- Update wheel rotational center
- Update wheel bearings
- Optimize toe, caster and camber

Closed 2021-02-10.

Thread 18 (2021-01-14):

Weak spot front axle shaft

MatthiasRubin, 2021-01-14:
Due to printing direction, there is e weak spot on the front axle shaft.

- Change printing direction

Closed 2021-02-10.

Thread 19 (2021-01-14):

Weak spot rear axle input shaft

MatthiasRubin, 2021-01-14:
Due to printing direction and small diameter, there is a weak spot on the rear axle input shaft.

- Change printing direction
- Increase diameter eventually

Closed 2021-02-06.

Thread 25 (2021-01-14):

Control motor and steering

MatthiasRubin, 2021-01-14:
- Add motor controller
- Add servo controller
- Control servo and motor speed over a joy stick

Closed 2021-01-21.

Thread 44 (2021-02-01):

Unstable bearing on rear axle input shaft

MatthiasRubin, 2021-02-01:
Bearing on rear axle input shaft is not fixed properly. Therefore, the input shaft wobbles.
- Enhance housing
- Use two bearings if necessary

Closed 2021-02-06.

Thread 50 (2021-02-06):

Battery and electronics holder

MatthiasRubin, 2021-02-06:
- Add holder/housing for battery
- Add holder/housing for h-bridge
- Add holder/housing for pcb

Thread 67 (2021-02-10):

Too much clearance on front axle

MatthiasRubin, 2021-02-10:
Too much clearance on front axle shaft:

- Improve connection between shaft and wheel hub
- Improve connection between shaft and bearing
- Improve connection between bearing and bearing housing (steering knuckle)

Thread 78 (2023-08-08):

Stability improvement on front axle

MatthiasRubin, 2023-08-08:
There are some weak spots at the front axle
- thicker rods, pins and pin hole supports
- enforcement around the nuts in the bottom axle beam
- screws at the side of the axle beans if necessary
