MatthiasRubin/rc-truck/(commit log)

2020-12-22 Added truck module
    [rc-truck.scad]
2020-12-22 Added wheel
    [rc-truck.scad]
2020-12-22 Added four wheels and basic frame
    [rc-truck.scad]
2020-12-22 Added axles
    [rc-truck.scad]
2020-12-22 Added cabin and box
    [rc-truck.scad]
2020-12-22 Attached cabin and box to frame First draft finished
    [rc-truck.scad]
2020-12-23 Added file for chassis Moved chassis parts to new file
    [chassis.scad, rc-truck.scad]
2020-12-23 Added files for frame, axle and wheel Added basic comments
    [axle.scad, chassis.scad, frame.scad, rc-truck.scad, wheel.scad]
2020-12-23 New printable and screwable frame
    [frame.scad]
2020-12-24 Divided frame into two pieces Added holes to put together
    [frame.scad]
2020-12-25 Splitted module axle into submodules
    [axle.scad]
2020-12-25 Split axle housing into bottom and top piece
    [axle.scad]
2020-12-25 Added comments
    [axle.scad, frame.scad, wheel.scad]
2020-12-27 New printable and screwable axle Changed alignment of axle
    [axle.scad, frame.scad, rc-truck.scad]
2020-12-28 Added printable and mountable wheel
    [axle.scad, frame.scad, wheel.scad]
2020-12-28 Added file for front axle
    [chassis.scad, frontAxle.scad, rearAxle.scad]
2020-12-29 Added front axle
    [frontAxle.scad]
2020-12-31 Added comments Simplified code
    [frontAxle.scad]
2021-01-02 Changed wheel shaft to be printable and mountable Added gitignore file to ignore stl files
    [frontAxle.scad, rearAxle.scad, wheel.scad]
2021-01-07 Reduced wheel hole radius
    [wheel.scad]
2021-01-07 Added new copy functions
    [copy.scad]
2021-01-07 Integrated copy functions
    [chassis.scad, frame.scad, frontAxle.scad, rc-truck.scad, rearAxle.scad, wheel.scad]
2021-01-07 Regrouped code
    [frame.scad, frontAxle.scad, rearAxle.scad]
2021-01-07 Added library for gears (https://www.thingiverse.com/thing:1604369/files)
    [Getriebe.scad]
2021-01-07 Added parametric gear module
    [frame.scad, frontAxle.scad, gears.scad, rearAxle.scad, wheel.scad]
2021-01-08 Added rear axle gears Changed rear axle shaft Added bearings
    [gears.scad, rearAxle.scad]
2021-01-11 Added small bearing Updated bottom housing Changed input shaft
    [rearAxle.scad]
2021-01-11 Added support to output gear Increased gear module to 0.9 Switched to parametric design
    [rearAxle.scad]
2021-01-12 Added basic parametric housing
    [gears.scad, rearAxle.scad, wheel.scad]
2021-01-13 Added mounting support to rear axle Added smooth design to rear axle
    [rearAxle.scad]
2021-01-13 Added support to mount rear axle
    [rearAxle.scad]
2021-01-14 Added rear wheel
    [frontAxle.scad, frontWheel.scad, gears.scad, rearAxle.scad, rearWheel.scad]
2021-01-14 Added motor
    [chassis.scad, motor.scad, rearWheel.scad]
2021-01-18 Added drive shaft
    [chassis.scad, driveShaft.scad, frame.scad, frontAxle.scad, motor.scad, rc-truck.scad, rearAxle.scad]
2021-01-18 Disabled part view
    [driveShaft.scad, motor.scad]
2021-01-18 Added file for servo
    [servo.scad]
2021-01-19 Added servo Added double steering knuckle
    [chassis.scad, frontAxle.scad, rearAxle.scad, servo.scad]
2021-01-20 Added steering mechanism
    [chassis.scad, servo.scad, steering.scad]
2021-01-20 Added arduino project
2021-01-21 Added functions for drive and steer truck
2021-01-23 Added transmitter
    [test.scad]
2021-01-23 Decreased acceleration and steering angle speed
2021-01-27 Added voltage monitoring
2021-01-28 Added stop on battery low
2021-01-31 Changed pins for new pcb
2021-02-01 Unified wheel Added rim
    [frontAxle.scad, frontWheel.scad, rearAxle.scad, rearWheel.scad, wheel.scad]
2021-02-01 Added tire
    [wheel.scad]
2021-02-01 Optimized code for wheel
    [wheel.scad]
2021-02-01 Added transform library
    [transform.scad]
2021-02-01 Updated copy library
    [copy.scad]
2021-02-02 Integrated new transform library
    [chassis.scad, copy.scad, driveShaft.scad, frame.scad, frontAxle.scad, gears.scad, motor.scad, rearAxle.scad]
2021-02-02 Added dual wheels Added wheel hubs on rear axle
    [rearAxle.scad, wheel.scad]
2021-02-02 Updated rear axle shafts Added wheel hub latch
    [rearAxle.scad]
2021-02-03 Added wheel clip to wheelhub on rear axle
    [rearAxle.scad]
2021-02-03 Fixed gap between top and bottom housing
    [rearAxle.scad]
2021-02-03 Fixed printing issues
    [rearAxle.scad]
2021-02-03 Fixed unstable input bearing
    [rearAxle.scad]
2021-02-03 Improved printability
    [rearAxle.scad]
2021-02-03 Changed bearings Increased input shaft diameter
    [rearAxle.scad]
2021-02-04 Added second input bearing Added separate input shaft
    [rearAxle.scad]
2021-02-04 Added wheel clip
    [rearAxle.scad]
2021-02-04 Updated axle mount
    [rearAxle.scad]
2021-02-05 Improved wheel clip
    [rearAxle.scad, wheel.scad]
2021-02-05 Optimized wheel hub tolerances
    [rearAxle.scad]
2021-02-05 Added more screws to housing Optimized wheel clip pin angle
    [rearAxle.scad]
2021-02-06 Deleted old front axle Added wheel hub to front axle
    [frontAxle.scad]
2021-02-07 Added bearing, shaft and wheel hub latch Improved wheel hub
    [frontAxle.scad]
2021-02-08 Improved wheel hub Added steering knuckles and steering rod
    [frontAxle.scad, transform.scad]
2021-02-08 Added wheel clips to front axle
    [frontAxle.scad, rearAxle.scad, wheel.scad]
2021-02-09 Added caster Added basic axle beam Improved steering track rod
    [frontAxle.scad, rc-truck.scad]
2021-02-09 Added axle mount holes Improved axle beam
    [frontAxle.scad]
2021-02-10 Set up directory structure
    [Getriebe.scad, axleBeam.3mf, axleBeamBottom.stl, axleBeamTop.stl, bearing.stl, bearingHousing.stl, bearings.3mf, chassis.scad]
2021-02-11 Added basic leaf spring suspension
    [gears.scad, suspension.scad, suspension.stl]
2021-02-11 Completed front axle suspension
    [frontAxle.scad, suspension.3mf, suspension.scad, suspension.stl]
2021-02-13 Added new frame module Added rear section draft
    [chassis.scad, copy.scad, frame.scad, rearSection.scad, suspension.scad]
2021-02-13 Reorganized part structure
    [axleBeam.3mf, axleBeamBottom.stl, axleBeamTop.stl, bearing.stl, bearingHousing.stl, bearings.3mf, chassis.scad, doubleSteeringKnuckle.stl]
2021-02-13 Completed rear section
    [chassis.scad, frame.scad, rearAxle.scad, rearSection.scad, wheel.scad]
2021-02-14 Added front and middle section of chassis
    [axleMountFrame.stl, chassis.scad, frontAxle.scad, frontSection.scad, middleSection.stl]
2021-02-14 Changed cargo box and cabin size
    [rc-truck.scad]
2021-02-14 Deleted from all files
    [frame.scad, frontAxle.scad, frontSection.scad, rearAxle.scad, rearSection.scad, suspension.scad, wheel.scad]
2021-02-14 Printed frame
    [axleMountFrame.3mf, axleMountFrame.stl, chassis.scad, middleSection.3mf]
